roloran/ROLORAN-Hardware/MERLIN-CIRE-Button/MERLIN-CIRE-Button-firmware/docs/images/backside-orientation-small.jpg

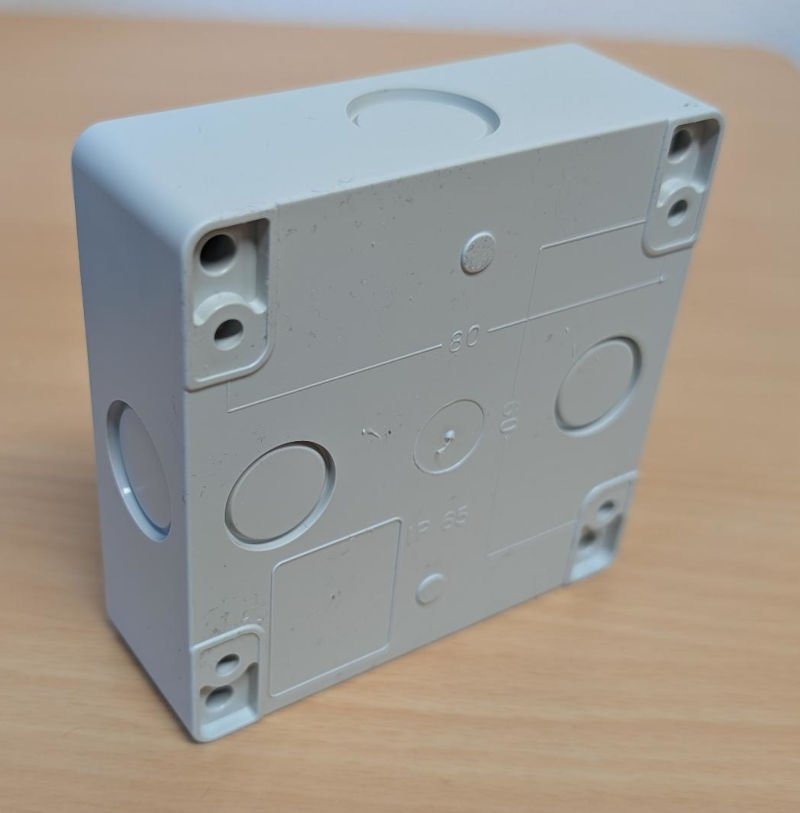
MERLIN-CIRE-Button/MERLIN-CIRE-Button-firmware/docs/images/backside-orientation-small.jpg
