roloran/ROLORAN-Hardware/MERLIN-CIRE-Button/MERLIN-CIRE-Button-firmware/docs/images/clamp-1.jpg

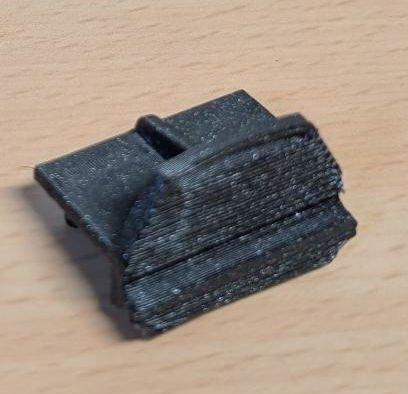
MERLIN-CIRE-Button/MERLIN-CIRE-Button-firmware/docs/images/clamp-1.jpg
