roloran/ROLORAN-Hardware/MERLIN-CIRE-Button/MERLIN-CIRE-Button-firmware/docs/images/clamps.jpg

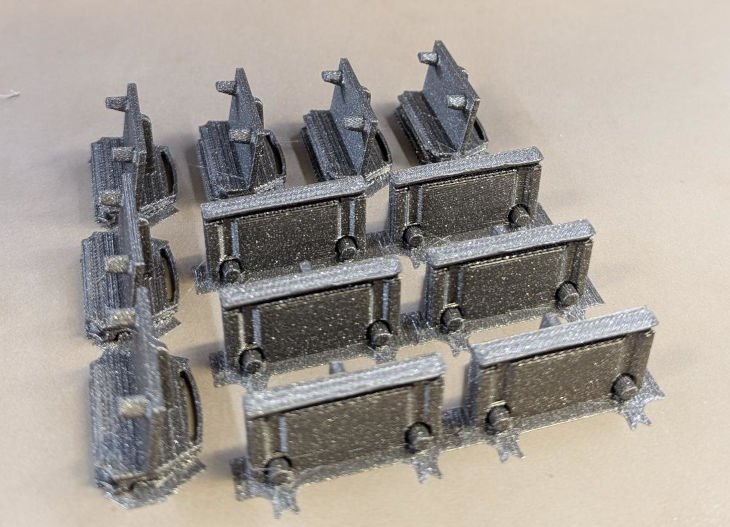
MERLIN-CIRE-Button/MERLIN-CIRE-Button-firmware/docs/images/clamps.jpg
