roloran/ROLORAN-Hardware/MERLIN-CIRE-Button/MERLIN-CIRE-Button-firmware/docs/images/closed-button.jpg

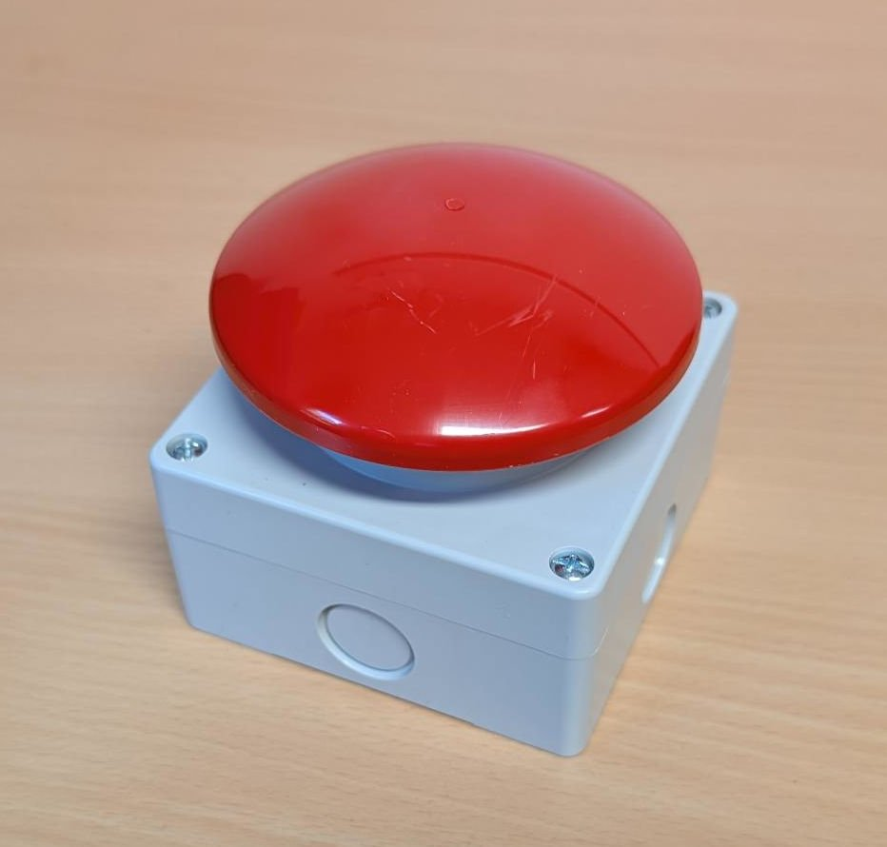
MERLIN-CIRE-Button/MERLIN-CIRE-Button-firmware/docs/images/closed-button.jpg
