roloran/ROLORAN-Hardware/MERLIN-CIRE-Button/MERLIN-CIRE-Button-firmware/docs/images/electrics.jpg

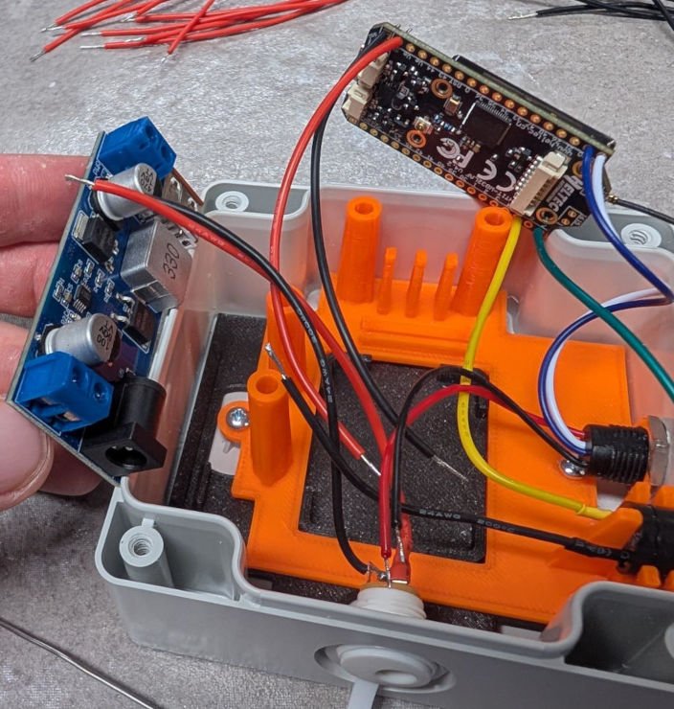
MERLIN-CIRE-Button/MERLIN-CIRE-Button-firmware/docs/images/electrics.jpg
