roloran/ROLORAN-Hardware/MERLIN-CIRE-Button/MERLIN-CIRE-Button-firmware/docs/images/ground-plate.jpg

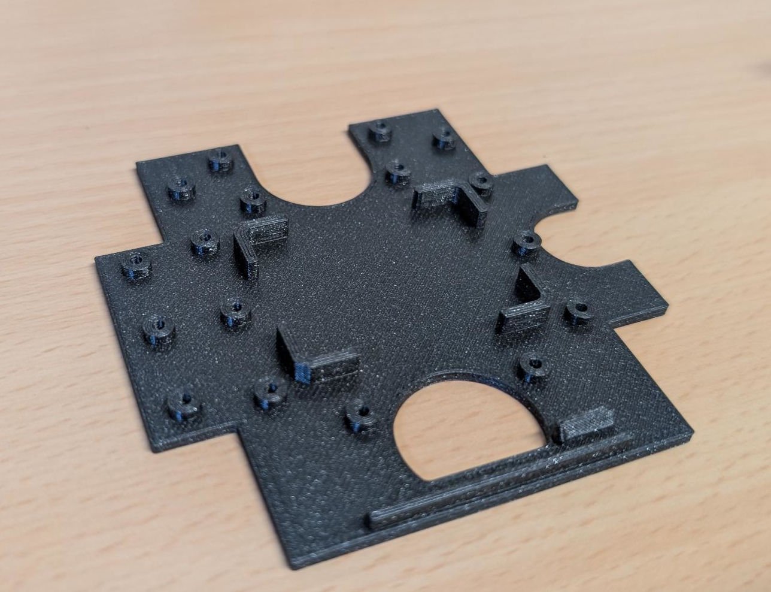
MERLIN-CIRE-Button/MERLIN-CIRE-Button-firmware/docs/images/ground-plate.jpg
