roloran/ROLORAN-Hardware/MERLIN-CIRE-Button/MERLIN-CIRE-Button-firmware/docs/images/inlay-grid.jpg

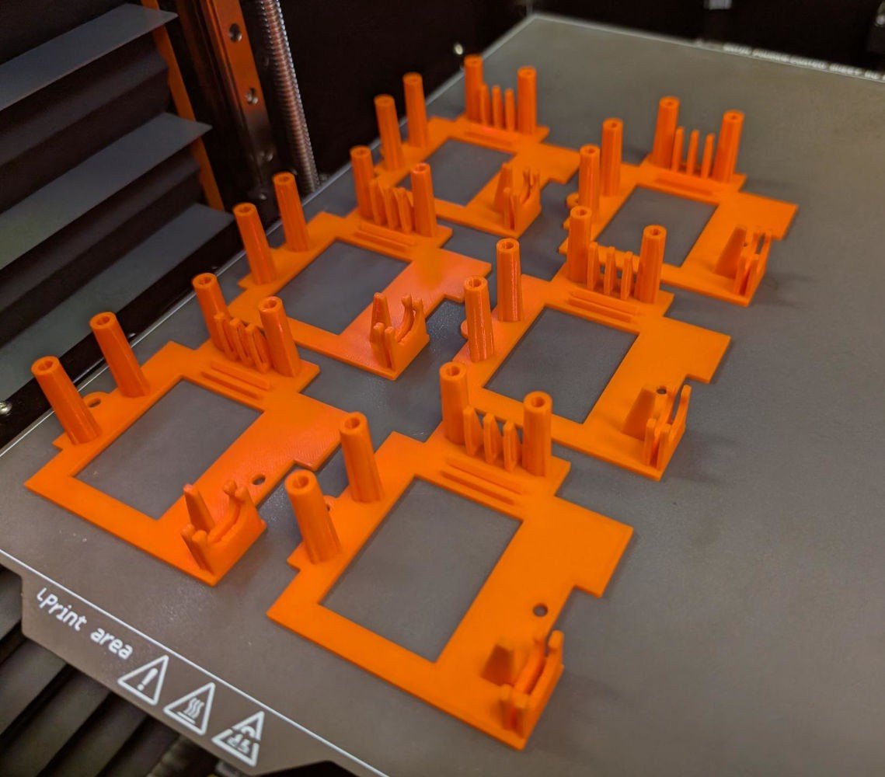
MERLIN-CIRE-Button/MERLIN-CIRE-Button-firmware/docs/images/inlay-grid.jpg
