roloran/ROLORAN-Hardware/MERLIN-CIRE-Button/MERLIN-CIRE-Button-firmware/docs/images/inlay.jpg

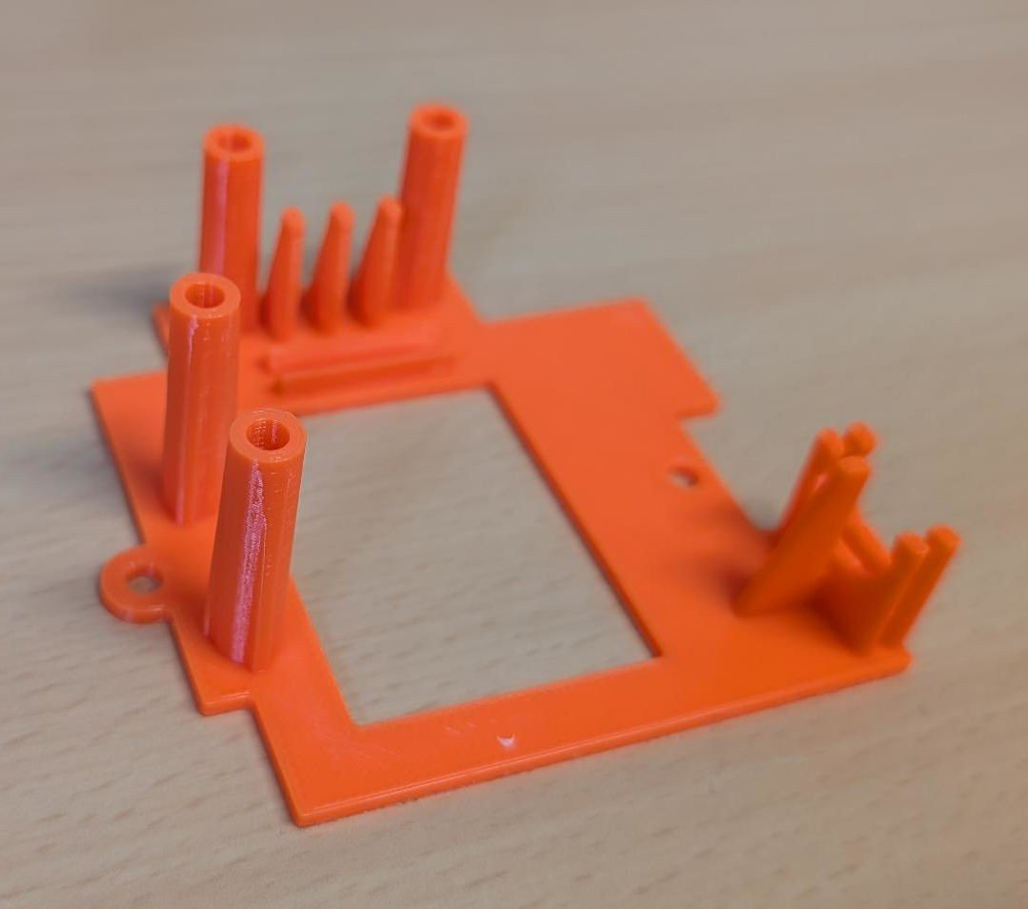
MERLIN-CIRE-Button/MERLIN-CIRE-Button-firmware/docs/images/inlay.jpg
