roloran/ROLORAN-Hardware/MERLIN-CIRE-Button/MERLIN-CIRE-Button-firmware/docs/images/interior-1.jpg

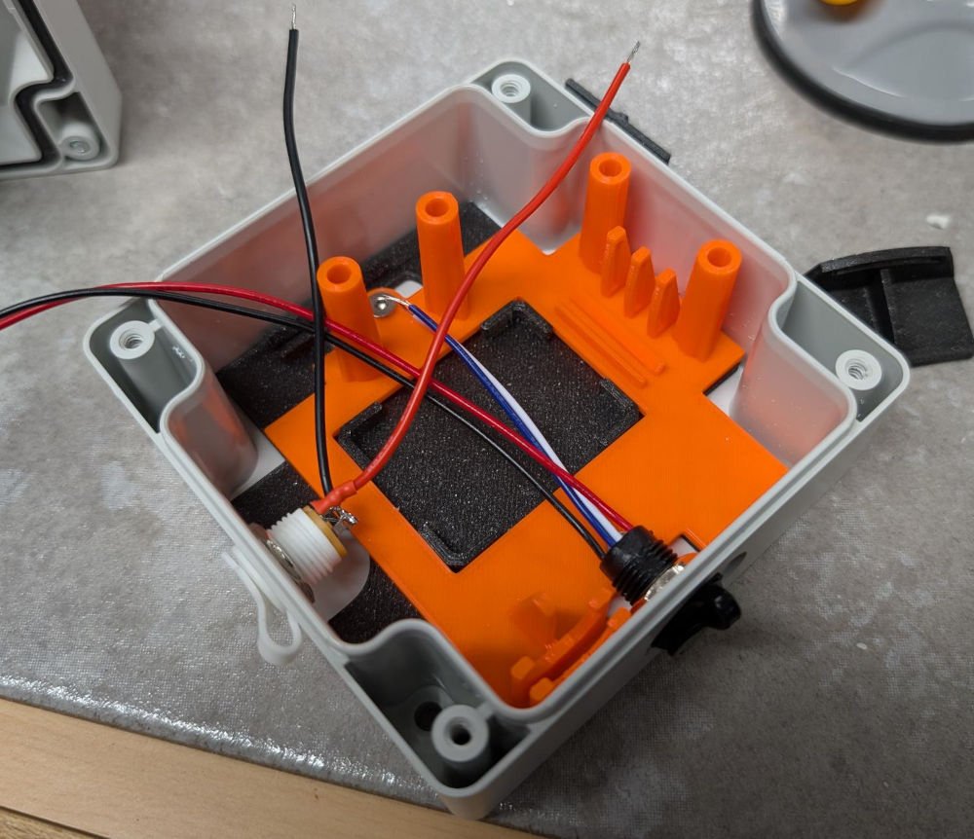
MERLIN-CIRE-Button/MERLIN-CIRE-Button-firmware/docs/images/interior-1.jpg
