roloran/ROLORAN-Hardware/MERLIN-CIRE-Button/MERLIN-CIRE-Button-firmware/docs/images/interior-2.jpg

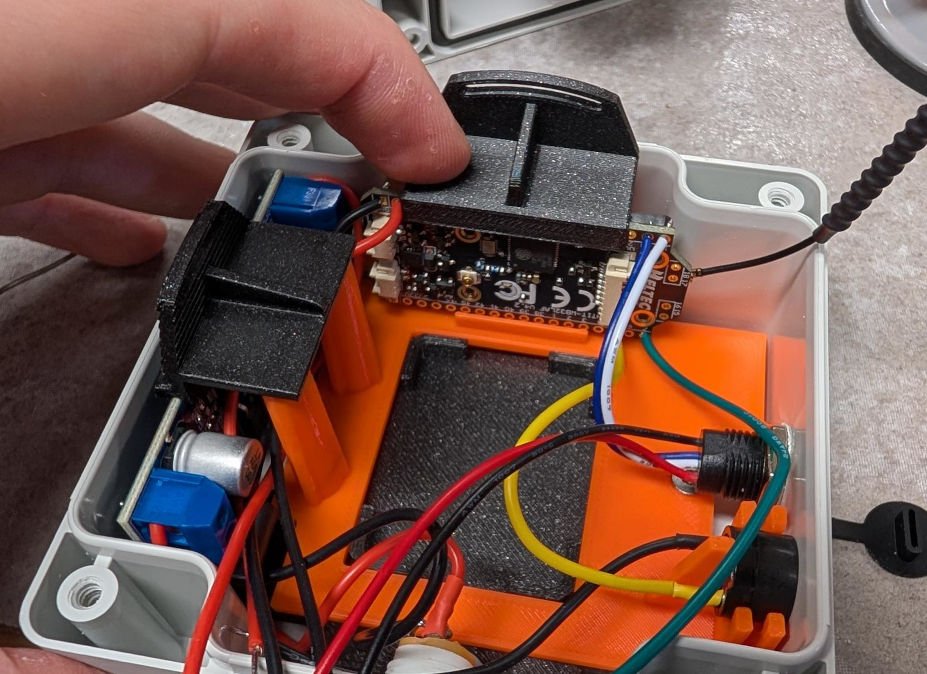
MERLIN-CIRE-Button/MERLIN-CIRE-Button-firmware/docs/images/interior-2.jpg
