roloran/ROLORAN-Hardware/MERLIN-CIRE-Button/MERLIN-CIRE-Button-firmware/docs/images/merlin-base-closed.jpg

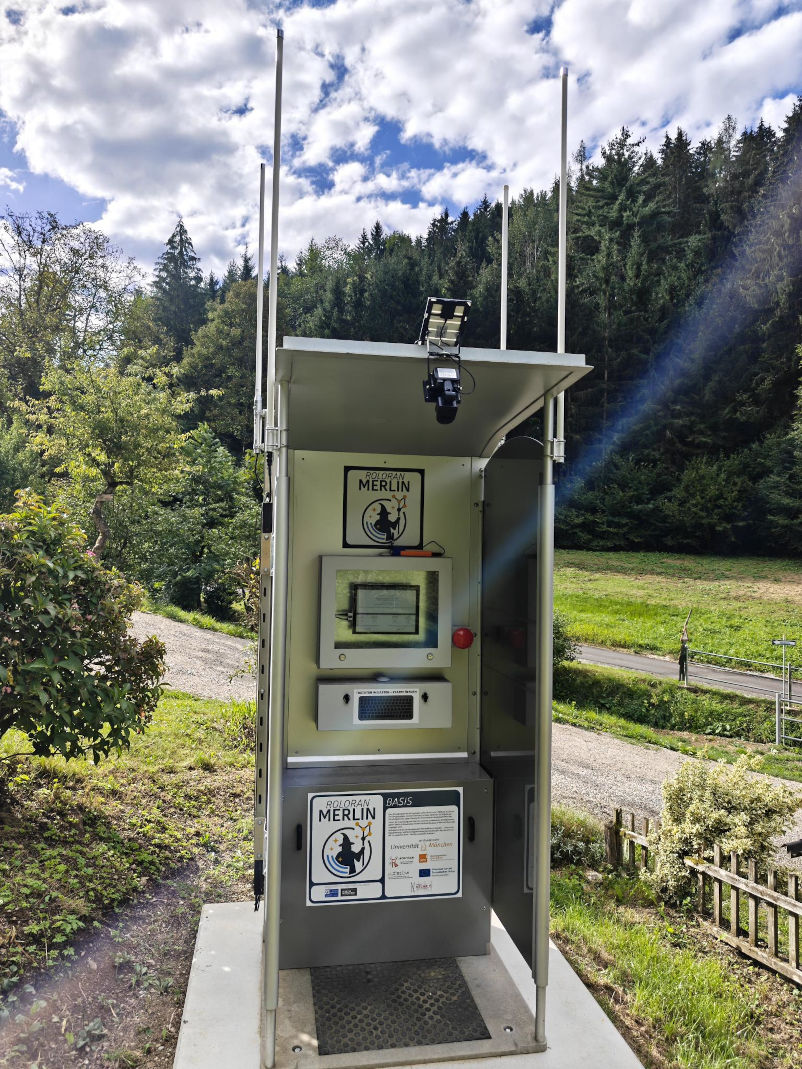
MERLIN-CIRE-Button/MERLIN-CIRE-Button-firmware/docs/images/merlin-base-closed.jpg
