roloran/ROLORAN-Hardware/MERLIN-CIRE-Button/MERLIN-CIRE-Button-firmware/docs/images/merlin-base-open.jpg

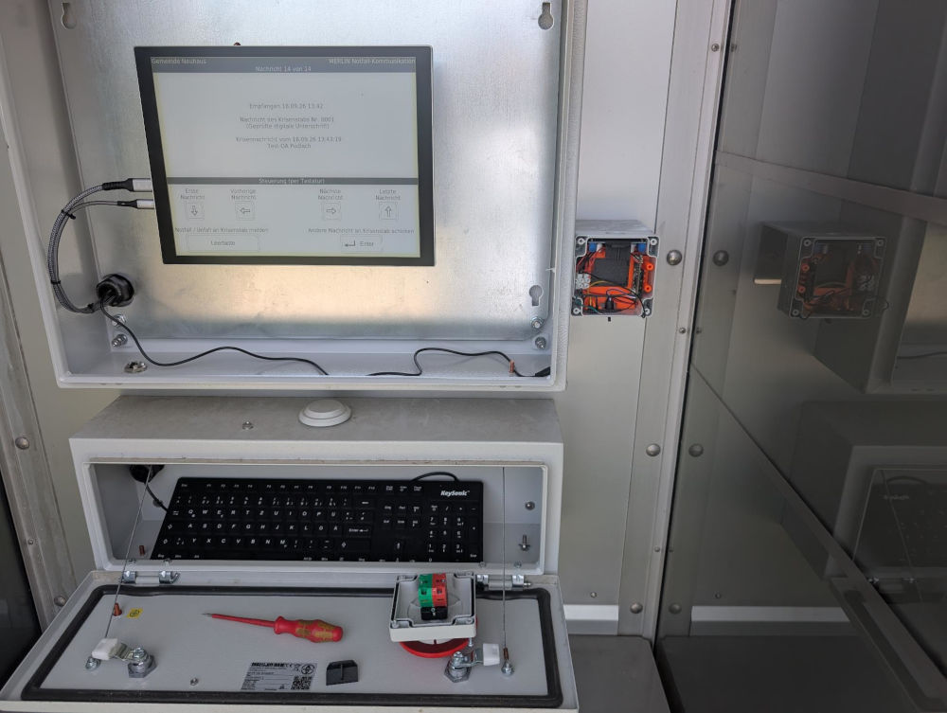
MERLIN-CIRE-Button/MERLIN-CIRE-Button-firmware/docs/images/merlin-base-open.jpg
