roloran/ROLORAN-Hardware/MERLIN-CIRE-Button/MERLIN-CIRE-Button-firmware/docs/images/opened-button.jpg

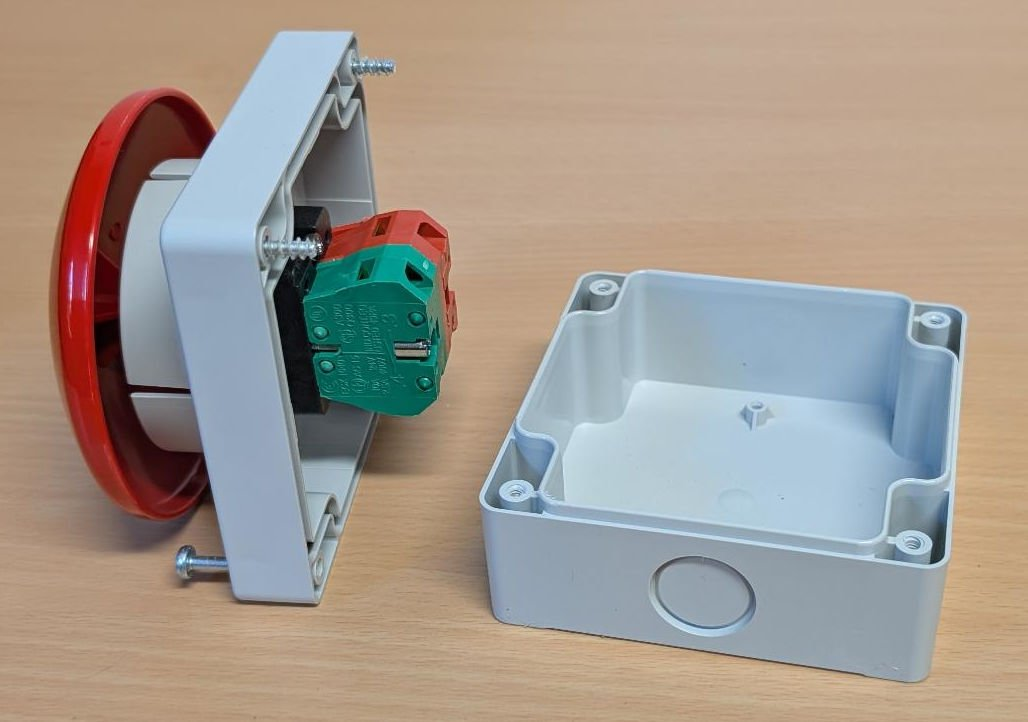
MERLIN-CIRE-Button/MERLIN-CIRE-Button-firmware/docs/images/opened-button.jpg
