roloran/ROLORAN-Hardware/MERLIN-CIRE-Button/MERLIN-CIRE-Button-firmware/docs/images/screw.jpg

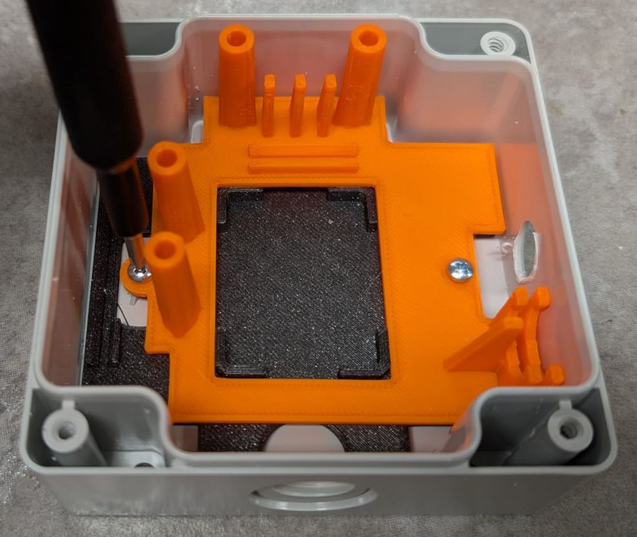
MERLIN-CIRE-Button/MERLIN-CIRE-Button-firmware/docs/images/screw.jpg
