roloran/ROLORAN-Hardware/MERLIN-CIRE-Button/MERLIN-CIRE-Button-firmware/docs/images/wired-esp.jpg

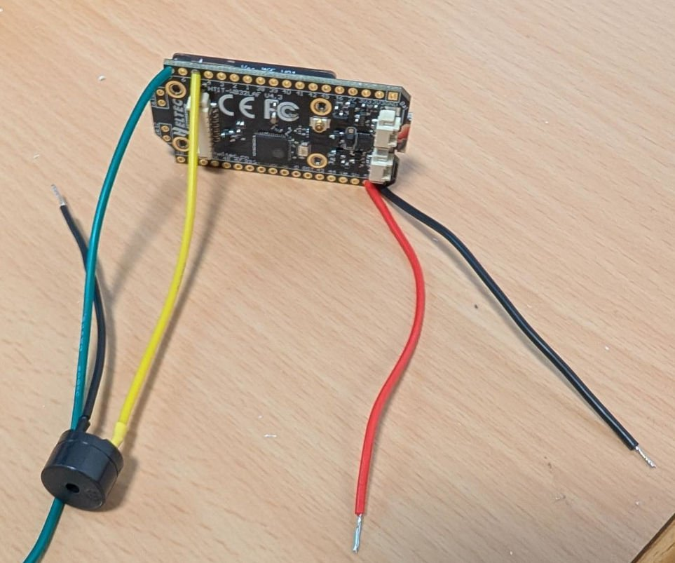
MERLIN-CIRE-Button/MERLIN-CIRE-Button-firmware/docs/images/wired-esp.jpg
