roloran/ROLORAN-Hardware/MERLIN-CIRE-Button/MERLIN-CIRE-Button-firmware/docs/resources/images/eu.png

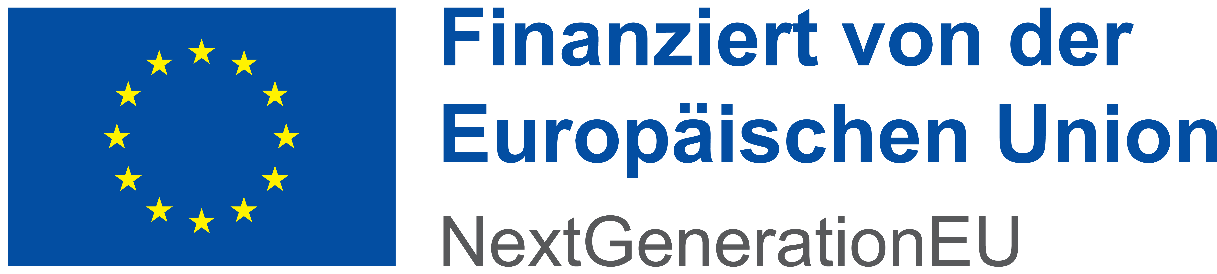
MERLIN-CIRE-Button/MERLIN-CIRE-Button-firmware/docs/resources/images/eu.png
