roloran/ROLORAN-Hardware/MERLIN-CIRE-Button/MERLIN-CIRE-Button-firmware/docs/resources/images/rolo.png

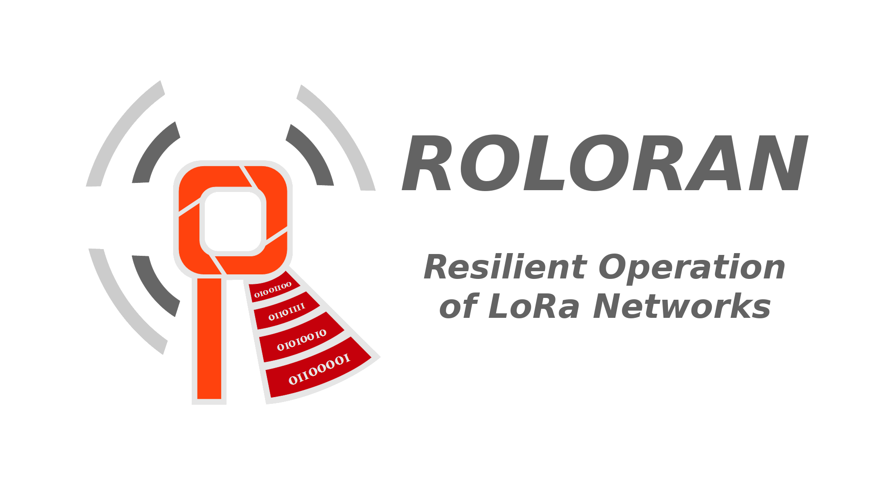
MERLIN-CIRE-Button/MERLIN-CIRE-Button-firmware/docs/resources/images/rolo.png
