roloran/ROLORAN-Hardware/MERLIN-Assist/MERLIN-Assist-enclosure/MERLIN-Assist-bottom.stl

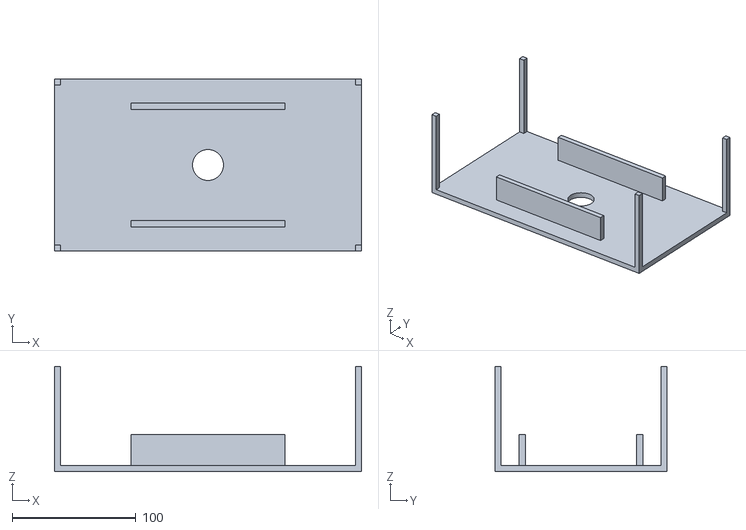
[picture p20: CAD file, 2026-06-11]
MERLIN-Assist/MERLIN-Assist-enclosure/MERLIN-Assist-bottom.stl
248.5 x 139.5 x 85.0
