roloran/ROLORAN-Hardware/MERLIN-Base/Elec_Components_Case_Simplified-Bohrschablone-Top.stl

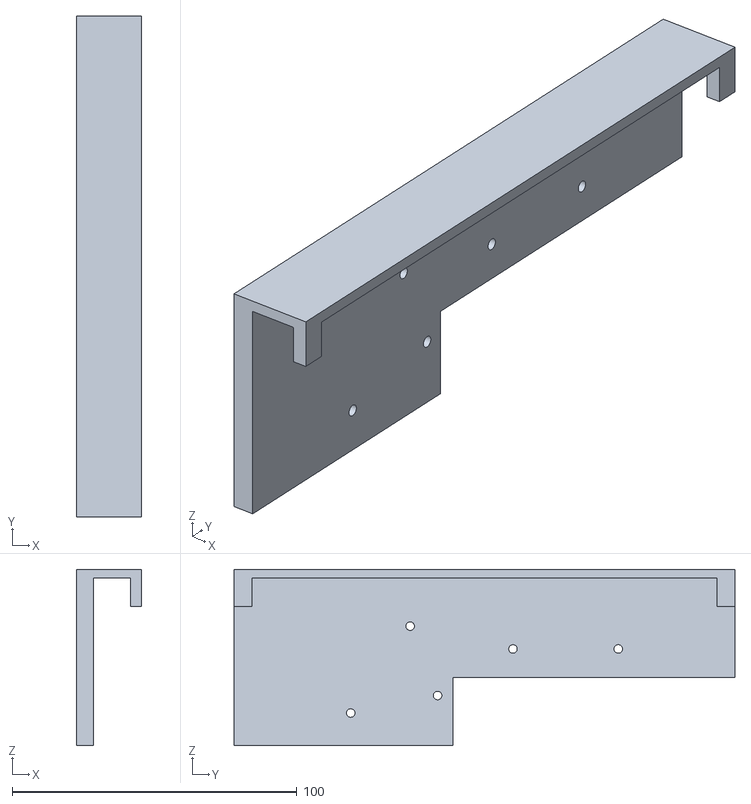
[picture p21: CAD file, 2026-10-15]
MERLIN-Base/Elec_Components_Case_Simplified-Bohrschablone-Top.stl
23.0 x 176.0 x 62.0
