roloran/ROLORAN-Hardware/MERLIN-CIRE-Button/MERLIN-CIRE-Button-hardware/MERLIN-CIRE-Button-Inlays-Ground Plate.stl

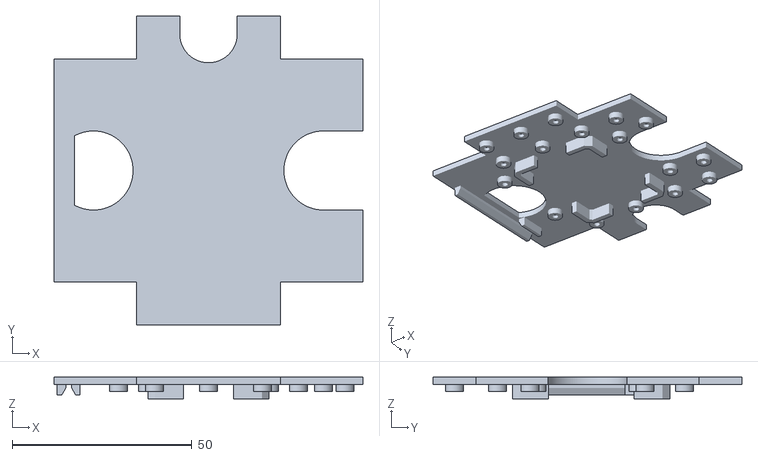
[picture p22: CAD file, 2026-10-15]
MERLIN-CIRE-Button/MERLIN-CIRE-Button-hardware/MERLIN-CIRE-Button-Inlays-Ground Plate.stl
86.0 x 86.0 x 6.00
