roloran/ROLORAN-Hardware/RDCP-Modem/RDCP-Modem-Base.stl

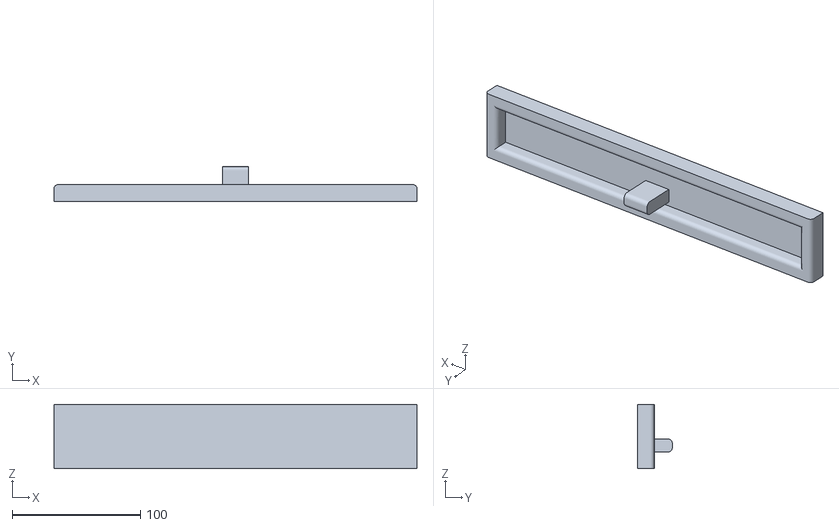
[picture p23: CAD file, 2026-10-09]
RDCP-Modem/RDCP-Modem-Base.stl
283.0 x 27.0 x 50.0
