roloran/ROLORAN-Hardware/MERLIN-Assist/MERLIN-Assist-enclosure/MERLIN-Assist-top.stl

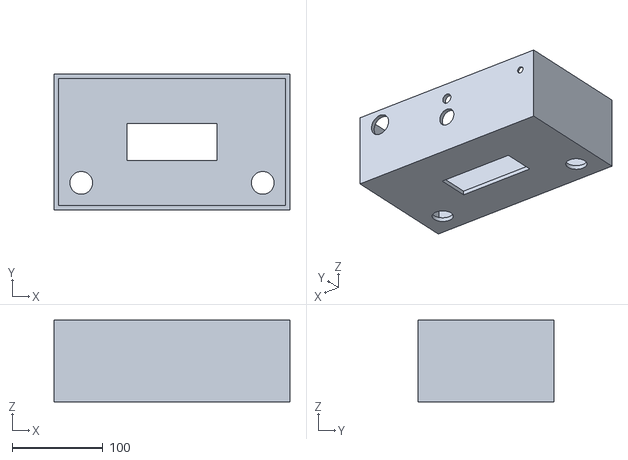
[picture p24: CAD file, 2026-06-11]
MERLIN-Assist/MERLIN-Assist-enclosure/MERLIN-Assist-top.stl
260.0 x 150.0 x 90.0
