roloran/ROLORAN-Hardware/MERLIN-Base/Elec_Components_Case-Kasten.stl

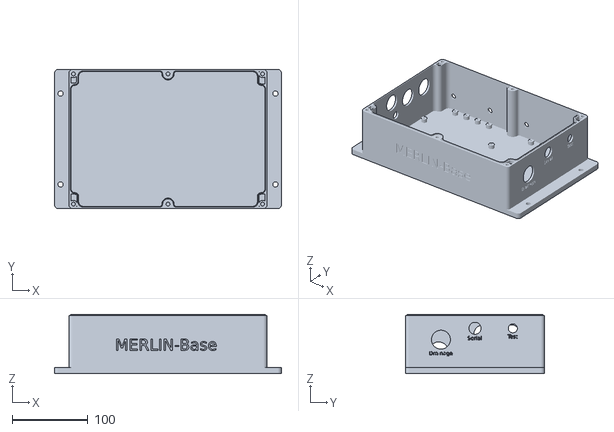
[picture p25: CAD file, 2026-10-15]
MERLIN-Base/Elec_Components_Case-Kasten.stl
300.0 x 184.0 x 78.5
