roloran/ROLORAN-Hardware/MERLIN-CIRE-Button/MERLIN-CIRE-Button-hardware/MERLIN-CIRE-Button-Inlays-Inlay.stl

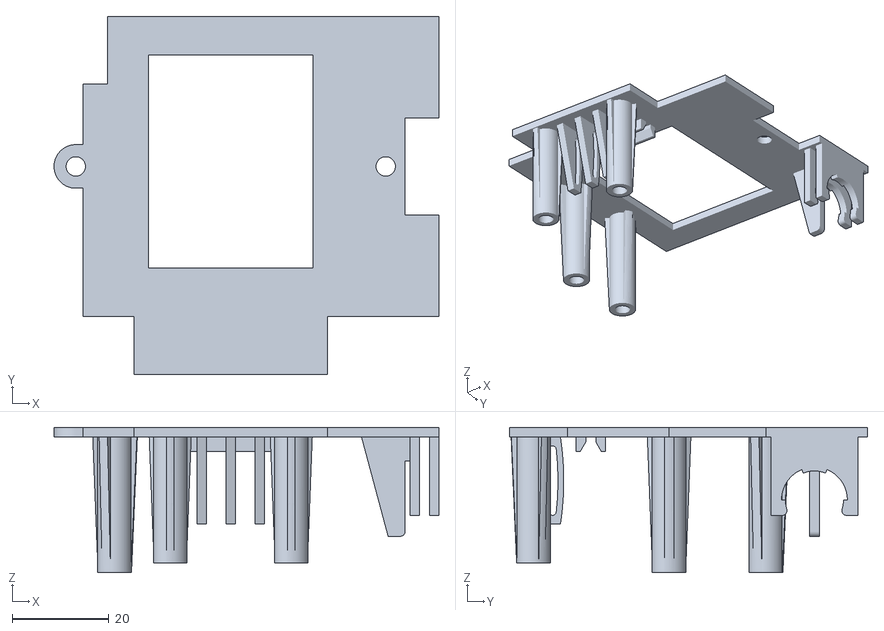
[picture p26: CAD file, 2026-10-15]
MERLIN-CIRE-Button/MERLIN-CIRE-Button-hardware/MERLIN-CIRE-Button-Inlays-Inlay.stl
79.5 x 74.0 x 30.0
