roloran/ROLORAN-Hardware/RDCP-Modem/RDCP-Modem-Case.stl

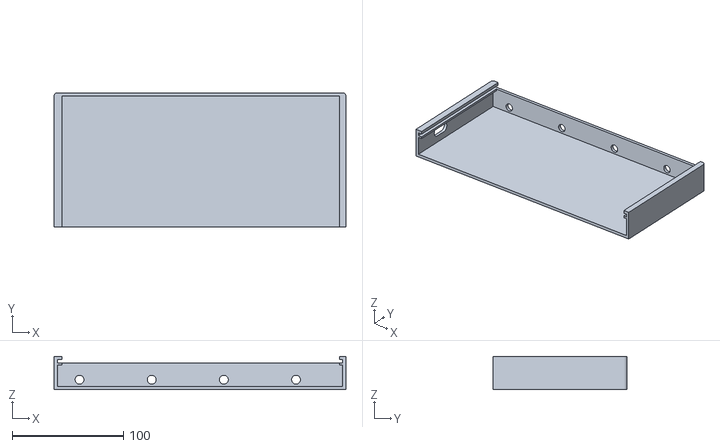
[picture p27: CAD file, 2026-10-09]
RDCP-Modem/RDCP-Modem-Case.stl
263.0 x 121.1 x 30.0
