roloran/ROLORAN-Hardware/MERLIN-Assist/MERLIN-Assist-enclosure/internal-clamp.stl

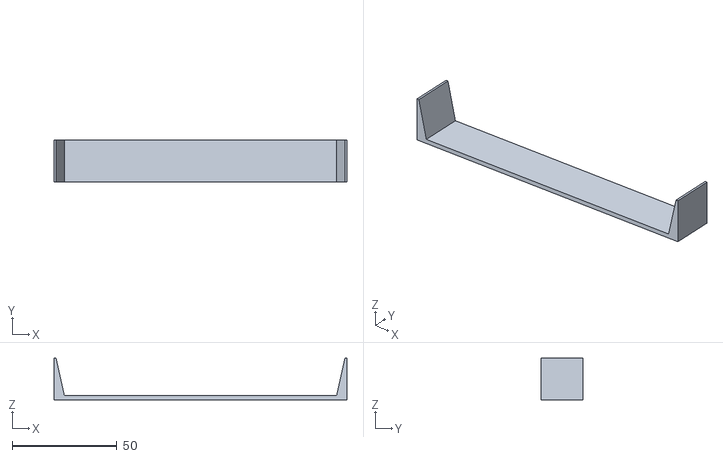
[picture p28: CAD file, 2026-06-11]
MERLIN-Assist/MERLIN-Assist-enclosure/internal-clamp.stl
140.0 x 20.0 x 20.0
