roloran/ROLORAN-Hardware/MERLIN-Base/Elec_Components_Case_Simplified-Bohrschablone-SMA.stl

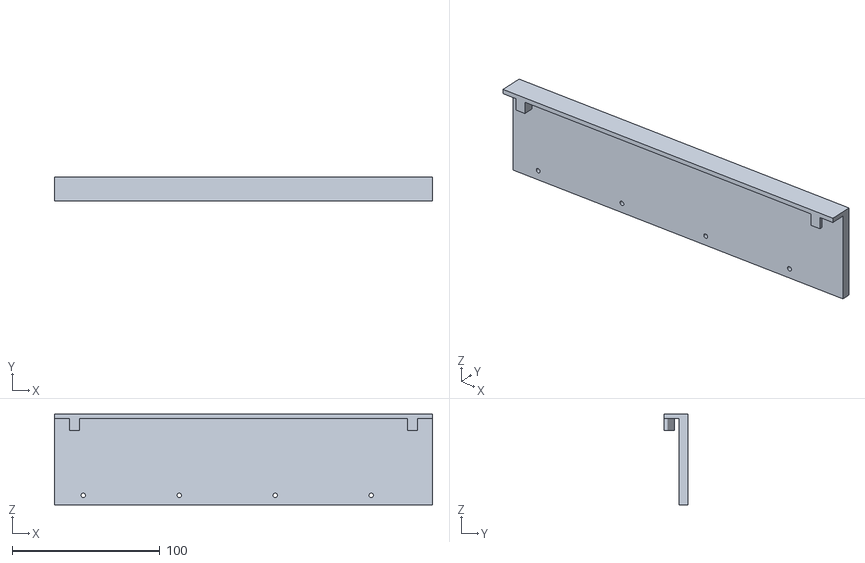
[picture p29: CAD file, 2026-10-15]
MERLIN-Base/Elec_Components_Case_Simplified-Bohrschablone-SMA.stl
256.0 x 16.0 x 61.5
