roloran/ROLORAN-Hardware/MERLIN-CIRE-Button/MERLIN-CIRE-Button-hardware/MERLIN-CIRE-Button-Inlays-Clamp 1.stl

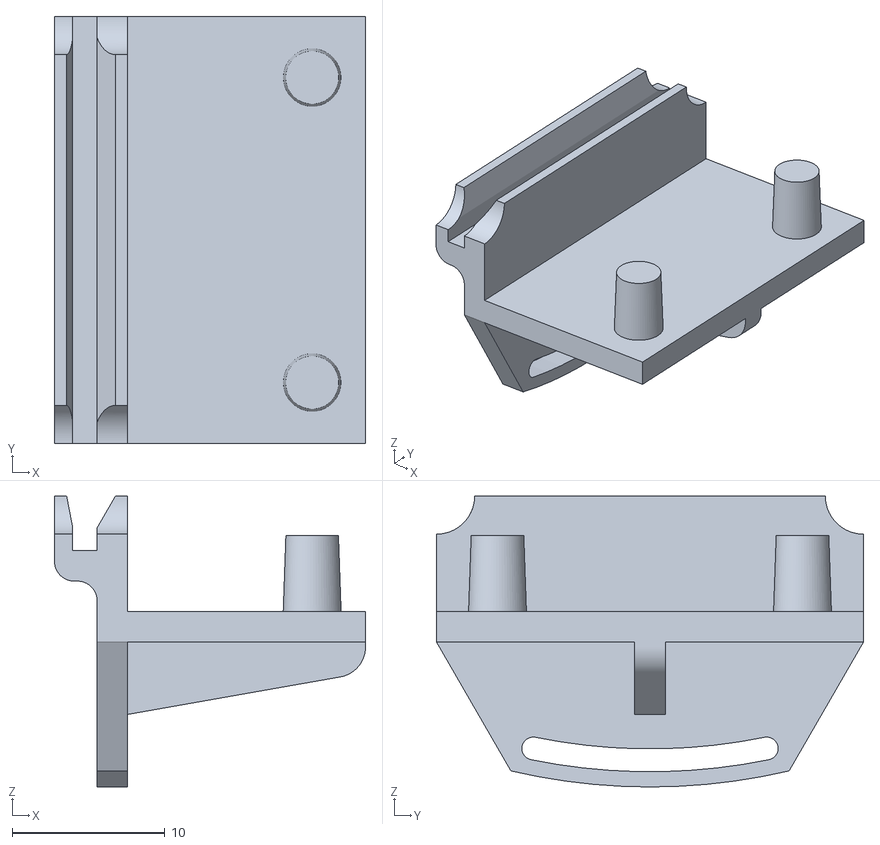
[picture p30: CAD file, 2026-10-15]
MERLIN-CIRE-Button/MERLIN-CIRE-Button-hardware/MERLIN-CIRE-Button-Inlays-Clamp 1.stl
20.4 x 28.0 x 19.1
