roloran/ROLORAN-Hardware/RDCP-Modem/RDCP-Modem-Back-Panel.stl

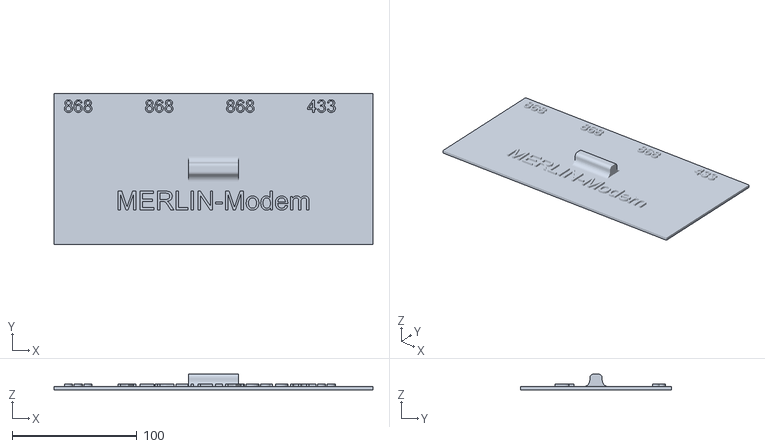
[picture p31: CAD file, 2026-10-09]
RDCP-Modem/RDCP-Modem-Back-Panel.stl
255.8 x 121.0 x 12.6
