roloran/ROLORAN-Hardware/MERLIN-Base/Elec_Components_Case.FCStd

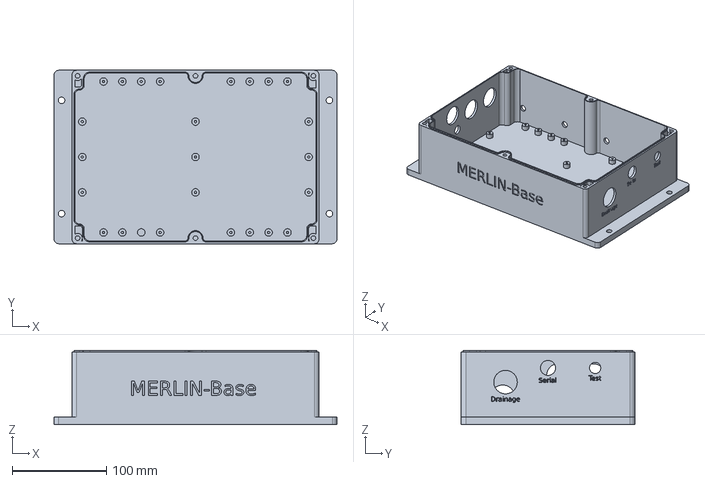
[picture p32: CAD file, 2026-10-15]
MERLIN-Base/Elec_Components_Case.FCStd
300.0 x 184.0 x 78.5 mm
