roloran/ROLORAN-Hardware/MERLIN-CIRE-Button/MERLIN-CIRE-Button-hardware/MERLIN-CIRE-Button-Inlays-Clamp 2.stl

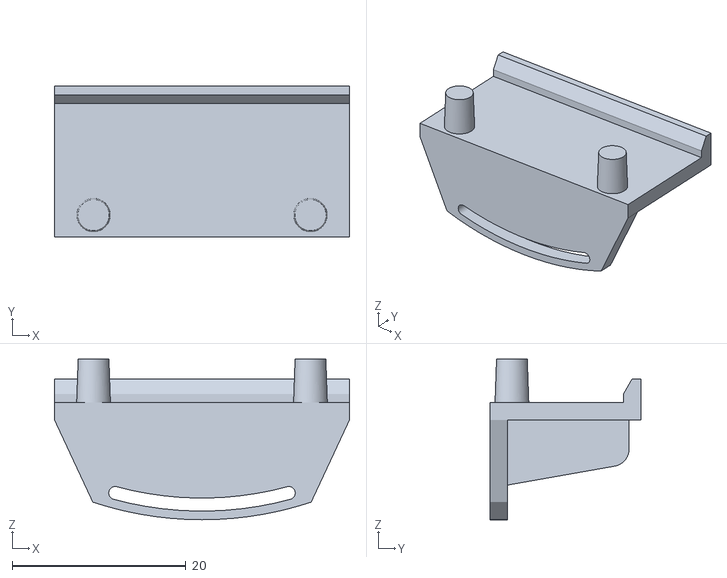
[picture p33: CAD file, 2026-10-15]
MERLIN-CIRE-Button/MERLIN-CIRE-Button-hardware/MERLIN-CIRE-Button-Inlays-Clamp 2.stl
34.0 x 17.4 x 18.5
