roloran/ROLORAN-Hardware/MERLIN-Base/Elec_Components_Case_Simplified-Case.stl

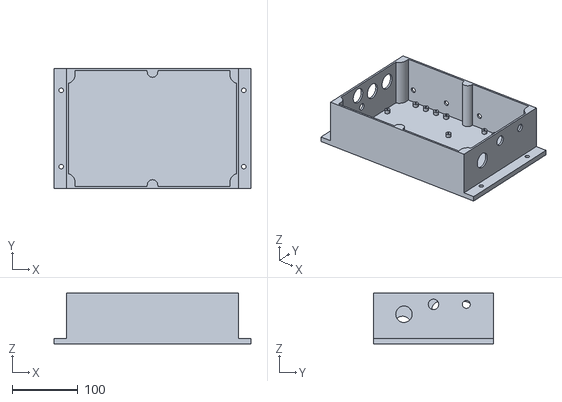
[picture p34: CAD file, 2026-10-15]
MERLIN-Base/Elec_Components_Case_Simplified-Case.stl
300.0 x 182.0 x 77.0
