roloran/ROLORAN-Hardware/MERLIN-CIRE-Button/MERLIN-CIRE-Button-hardware/MERLIN-CIRE-Button-Inlays.FCStd

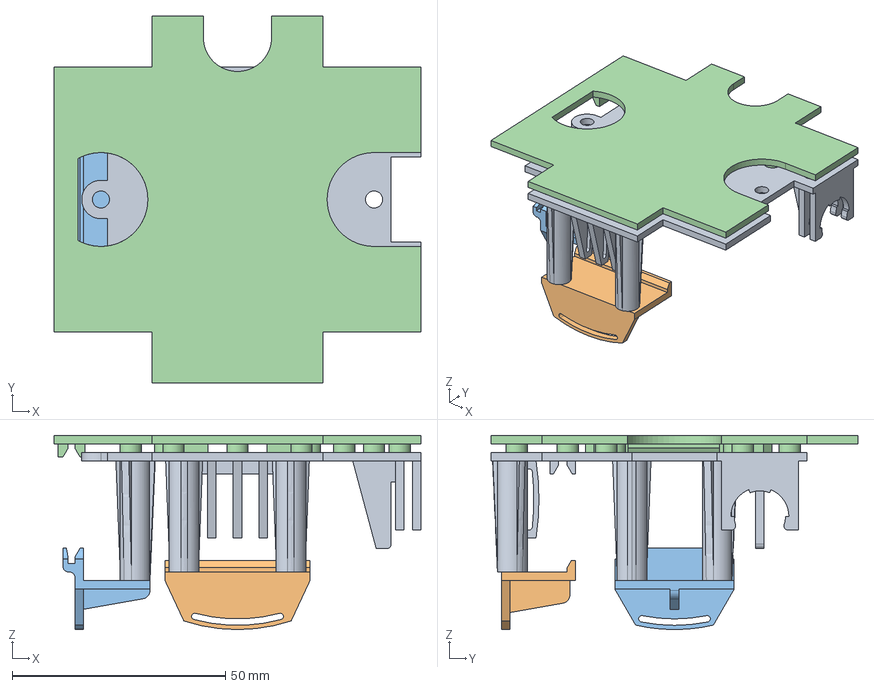
[picture p35: CAD file, 2026-10-15]
MERLIN-CIRE-Button/MERLIN-CIRE-Button-hardware/MERLIN-CIRE-Button-Inlays.FCStd
86.0 x 86.0 x 45.5 mm
Inlay
Clamp 2
Clamp 1
Ground Plate
