roloran/ROLORAN-Hardware/MERLIN-Base/Elec_Components_Case_Simplified-Bohrschablone-Bottom.stl

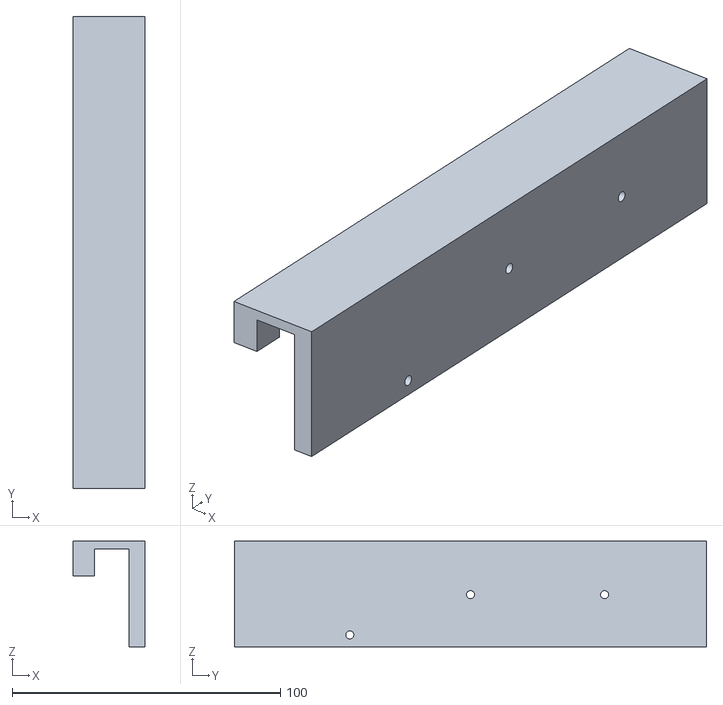
[picture p36: CAD file, 2026-10-15]
MERLIN-Base/Elec_Components_Case_Simplified-Bohrschablone-Bottom.stl
27.0 x 176.0 x 39.5
