roloran/ROLORAN-Hardware/MERLIN-Base/MERLIN-Base-PCB-Holder.stl

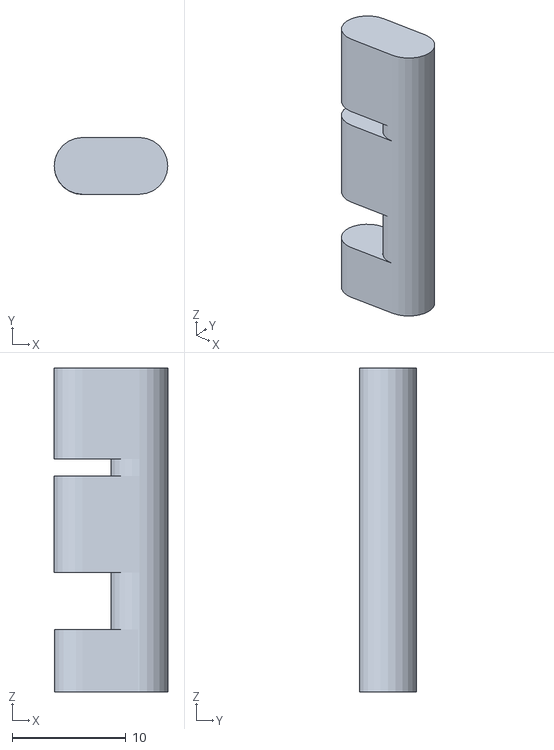
[picture p37: CAD file, 2026-10-09]
MERLIN-Base/MERLIN-Base-PCB-Holder.stl
10.0 x 5.02 x 28.5
