roloran/ROLORAN-Hardware/MERLIN-Base/MERLIN-Base-Inlay.stl

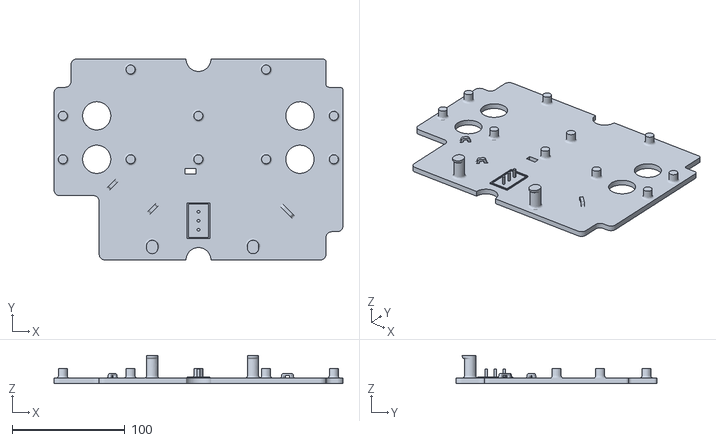
[picture p38: CAD file, 2026-10-09]
MERLIN-Base/MERLIN-Base-Inlay.stl
256.0 x 178.0 x 25.0
