roloran/ROLORAN-Hardware/MERLIN-Base/Elec_Components_Case_Cover.FCStd

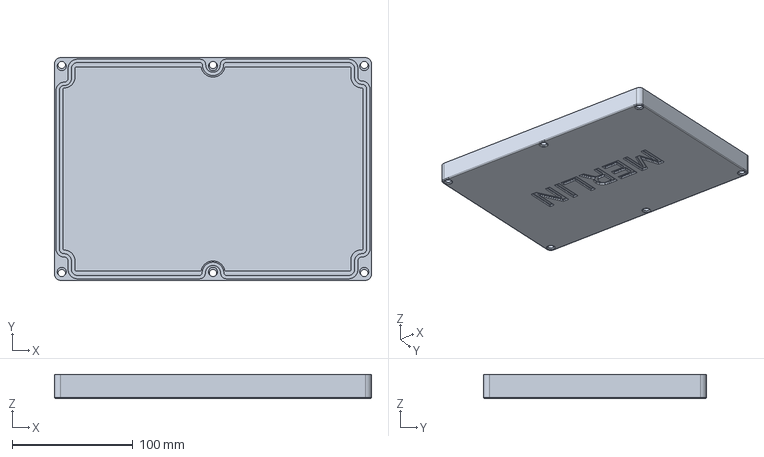
[picture p39: CAD file, 2026-08-04]
MERLIN-Base/Elec_Components_Case_Cover.FCStd
262.0 x 184.0 x 20.0 mm
