roloran/ROLORAN-Hardware/MERLIN-Base/Elec_Components_Case_Simplified.FCstd

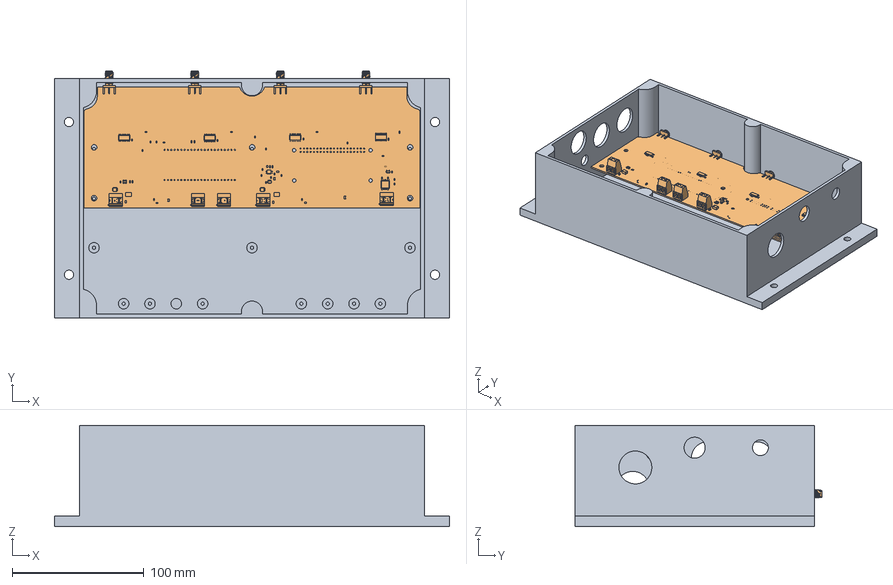
[picture p40: CAD file, 2026-08-03]
MERLIN-Base/Elec_Components_Case_Simplified.FCstd
300.0 x 187.9 x 77.0 mm
Case
LoRaQuadV2
