roloran/ROLORAN-Hardware/MERLIN-CIRE-Button/MERLIN-CIRE-Button-firmware/docs/manual.pdf

# RDCP Emergency Button Manual

# RDCP Emergency Button Manual


## Contents

## 1. List of Abbreviations

CIRE CITIZEN REPORT
MERLIN Messaging-System mit regionaler LoRa-Infrastruktur RDCP ROLORAN Disaster Communication Protocol

## 2. Introduction

This manual is meant as a companion document to the existing documentation of the ROLORAN Disaster Communication Protocol (‍RDCP‍) Emergency Button. The Emergency Button is part of the Messaging-System mit regionaler LoRa-Infrastruktur (‍MERLIN‍).

The Emergency Button is essentially a MERLIN-Messenger with only the capability to send one specific message type: the CITIZEN REPORT (‍CIRE‍). If pressed, it wirelessly sends out a predefined emergency report to be transported via MERLIN. It is meant to be used when writing a fully fledged report via a MERLIN-Base or MERLIN-Messenger would take to much time or if they cannot be physically operated anymore.

## 3. Build Instructions

Following the open architecture of the MERLIN project, you can build your own RDCP Emergency Button. The build instructions allow you to replicate the buttons as used by the project. You are, however, free to adapt the project to your own needs, e.g., by using a different case. In this case you may need to adapt the following steps.

### 3.1. Required Parts and Tools

You will need the following parts:

Component | Quantity | Info
Button Case | 1 | The project uses specific mushroom push buttons¹ for which the 3D models were optimized.
Heltec V4 | 1 | Microcontroller with integrated LoRa radio. Including appropriate antenna.

¹The concrete product used for the prototypes and featured in the images: https://intratec-shop.de/grobhandtasterpilztaster-notaus-ip65-pilzschalter-notausschalter-schalter-grobhandtaster-druck/JSSL5103 (https://intratec-shop.de/grobhandtaster-pilztaster-notaus-ip65-pilzschalter-notausschalter-schalter-grobhandtaster-druck/JSSL5103)

Component | Quantity | Info
XY-3606 | 1 | Stepdown converter for converting 12V received via DC jack to 5V.
Passive Piezo Buzzer | 1 | Used for audio feedback
USB-C to 4 Wire Jack | 1 | Jack to connect USB pins of Heltec V4 to.
DC5521 Jack | 1 | Jack for 12V main power supply.
M3 x 8 Screws | 2 | For securing the inlay to the case.
Filament | n/a | Filament of your choosing to print the inlay. The project used PLA.
Electric wire (ideally 24 AWG) | n/a | Cabling
Terminal Block | 2 | Optional: Can be used as shared mass/5V

You will also need access the following tools:

Tool | Info
3D Printer | To print the inlay parts with your filament.
Screwdriver Set | Case screws, M3 screws, XY-3606 screws, etc.
Soldering Station | For soldering cables, etc.
Step Drill (10 - 14mm) | Drilling holes into the case for the two jacks.

### 3.2. 3D Printing Parts

There are four parts the need to be printed.

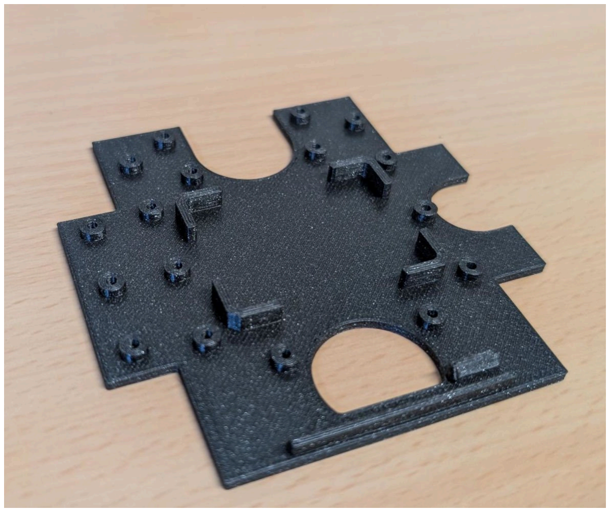
[picture p41: figure]
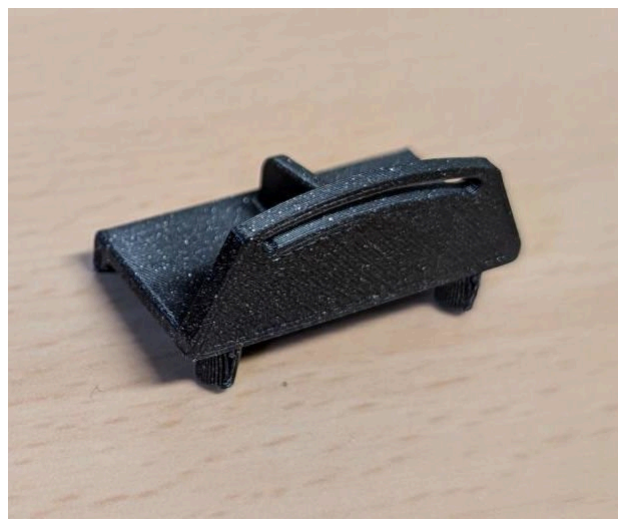
[picture p42: figure]

Figure 1: Ground plate | Figure 2: Inlay | Figure 3: Clamp 1 | Figure 4: Clamp 2

Ground plate and inlay can be printed without supporting structures, while clamp 1 and clamp 2 are best printed with support enforcers only. The pins on the clamps likely require a little amount filing to get them to smoothly fit into the receptacles of the inlay. They do not need to stick to the receptacles by themselves, as they will be held in place by the lid of the button. If building more than one button its generally recommended to print each part multiple time in parallel. Parts can be combined as long as they use the same plastic and print settings (e.g. printing clamp 1 and 2 together is generally fine). These four parts (ground plate, inlay, clamp 1 and 2) will later be assembled as shown in the 3D render.

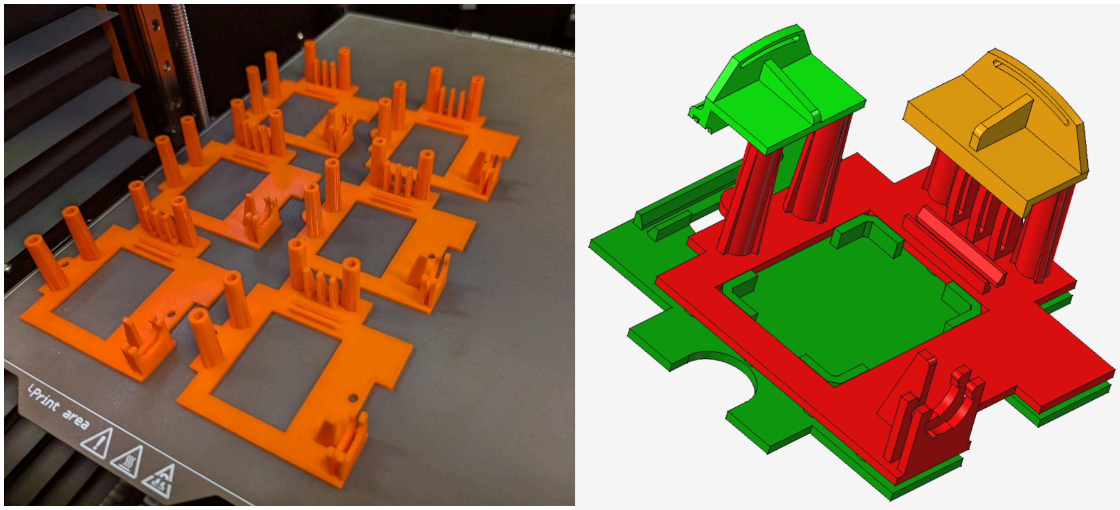
[picture p43: figure]

### 3.3. Assembly Steps

1. Unscrew the lid and open the button.


2. Identify the two points for the holes of the jacks by ensuring that the text on the backside of the button is upright. The two holes shall be made on the top and left insets when the opening of the case is facing away from you. Use a step drill to create a hole for the USB-C to 4 Wire Jack on the top and a hole for the DC5521 Jack on the left side. Note that the jacks may require holes of slightly different diameters.


After creating the necessary holes you may insert first the ground plate and afterward the inlay. Fixate the inlay with two screws. Afterward, insert the outlets through the new holes.

3. Perform the electrical wiring according to the following schematic.

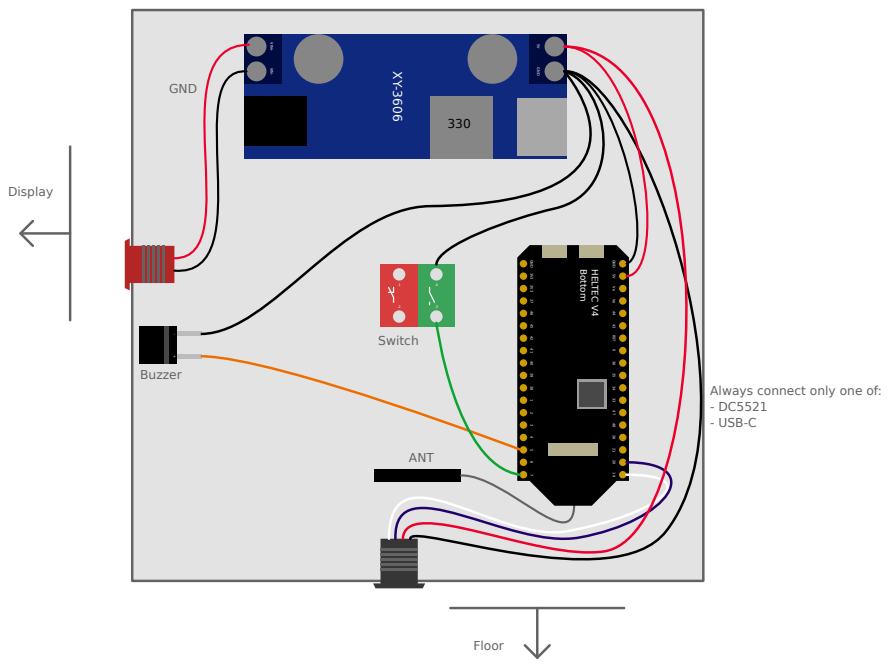
[picture p44: figure]
ANT; Always connect only one of: - DC5521 - USB-C; Display; Switch; Buzzer; GND; HELTEC V4 Bottom; 5V GND; VIN+ VIN-; Floor

GND 5V Ve Ve 44 43 RST 0 36 35 34 33 47 48 26 21 20 19

GND 3V3 3V3 37 46 45 42 41 40 39 38 1 2 3 4 5 6 7

Instead of connecting all mass to the XY-3606 step down converter you may alternatively use a terminal block, same for the two 5V connections.

Its recommended to first prepare and solder the step down converter and the Heltec V4 separately.

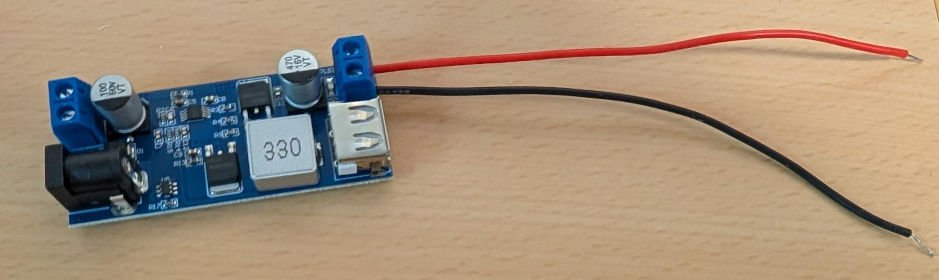
[picture p45: figure]

After preparing both components, insert them into the respective insets of the inlay. Connect all necessary wires. Finally, secure the two components via the 3D-printed clamps.


The last two remaining wires should be connected to the switch on the lid. By screwing down the lid, the clamps are at the same time pushed down by lid and are thus firmly held in place.

## 4. Usage

This section explains how an assembled unit may be utilized.

Warning

The Heltec V4 board supports power supply via either 5V pins or USB². The button exposes the 5V pins via the DC5521 jack and the USB via the USB-C jack. Hence, the same restrictions apply to these two jacks.

### 4.1. Flashing

Flashing is performed via the USB-C port. Note that while appearing as a physical USB-C port, the 4 wire variant used does not actually constitute a valid USB-C interface but is rather a legacy interface. Using USB-C to USB-C cables will thus fail. Instead, utilize a USB-C to USB-A cable and connect the USB-A end to a computer.

The firmware for the button is build and distributed as a PlatformIO project. Assuming that PlatformIO is already installed and no other USB CDC devices are connected you may issue the following command inside the root directory of this project:

pio run -e heltec_wifi_lora_32_V4 --target upload --upload-port /dev/ttyACM0

This command builds and subsequently flashes the current codebase. You may checkout any commit/ branch if you require a specific firmware version.

Sometimes Heltec V4 do not allow flashing. In this case you need to access the microcontroller and physically hold the PROG button pressed while triggering a reboot through a short press on RST. After performing this once it should be flashable afterwards.

### 4.2. Provisioning

Provisioning is performed via the USB-C port. See the restrictions from the previous section.

The easiest way is to use an operational MERLIN-HQ. The MERLIN-HQ has a dedicated provisioning setting for emergency buttons. It can also provide the correct crypto material for the given infrastructure.

For manual provisioning, e.g., during testing you may utilize the ROLORAN-Terminal application to connect to the button. Then copy the following initscript while replacing any placeholders XXXX with the concrete values.

+SET RADIO NUM 1
+SET CHANNEL NUM 2
+SET CHANNEL LORA 00 869.525 125 7 5 12 22 15 1 2 +SET CHANNEL LORA 01 869.525 125 7 5 12 22 15 1 2 +SET RADIO SX1262 0 0 1 11 10 09 08 14 13 12 -1 -1 0 +SET RADIO INTERFACE 0 0 0 1 0 -1 -1 -1 -1
+SET RDCP ADDR XXXX
+SET RDCP ENTRYPOINT XXXX
+SET RDCP HQAESKEY XXX
+SET RDCP HQPUBKEY XXX
+RADIOINIT
+SLEEP WAKEUPPIN 7

²https://resource.heltec.cn/download/WiFi_LoRa_32_V4/datasheet/WiFi_LoRa_32_V4.2.0.pdf

### 4.3. Installation

Installation just requires the connection of a 12V DC5521 plug to the corresponding jack on the button. The button should indicate successful boot through a short beeping sequence. Allow 5 seconds after boot for finalizing its setup. Now the button is ready and may be pressed anytime to fire an RDCP CIRE message via the configured MERLIN-Base.

The pictures below show the installation in a MERLIN-Base in Neuhaus.


## 5. Disclaimer and Contact


The ROLORAN project of which MERLIN is a part of is financed by the European Union as part of the NextGenerationEU program.

All contents of this document are governed by the License which can be found in the project repository.

Contact information:

Website https://go.unibw.de/roloran Mail projekt-roloran@unibw.de
