roloran/ROLORAN-Hardware/MERLIN-CIRE-Button/MERLIN-CIRE-Button-firmware/docs/images/assembled-3d-small.png

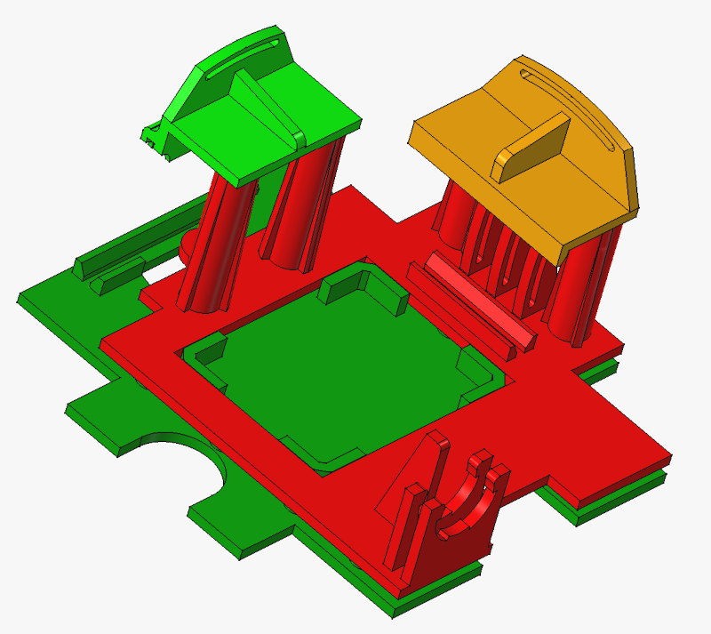
MERLIN-CIRE-Button/MERLIN-CIRE-Button-firmware/docs/images/assembled-3d-small.png
