roloran/ROLORAN-Hardware/MERLIN-Assist/MERLIN-Assist-firmware/test/README

Directory for RDCP-Modem implementation tests.
