roloran/ROLORAN-Hardware/(commit log)

2025-04-25 Add files via upload
    This customized printed circuit board comprises an ESP32 and two Ebyte E22 LoRa Modules. The files were created with KiCad (v.8.0).
    [LoRaDualv1_1.kicad_pcb, LoRaDualv1_1.kicad_sch]
2026-02-24 additional push button added
    [quad.kicad_pcb, quad.kicad_sch]
2026-03-04 Add files via upload
    fixing some errors.
    [LoRaQuadV2.kicad_pcb, LoRaQuadV2.kicad_sch]
2026-06-11 Initial MERLIN Assist prototype
2026-10-09 Add enclosure for RDCP-Modem based on quad relay PCB
2026-10-15 Add the RDCP-CIRE-Button project to the public repository
2026-10-15 Reorganize the repository
    + Move PCB files into separate directory
    + Update README files
2026-10-15 Add STL files
